IceyMu/Leverless-Controller/README.md

# Leverless-Controller
 A Leverless Controller for Fighting Games
