IceyMu/Leverless-Controller/Rev2/SLDPRT/Leverless Controller.SLDASM

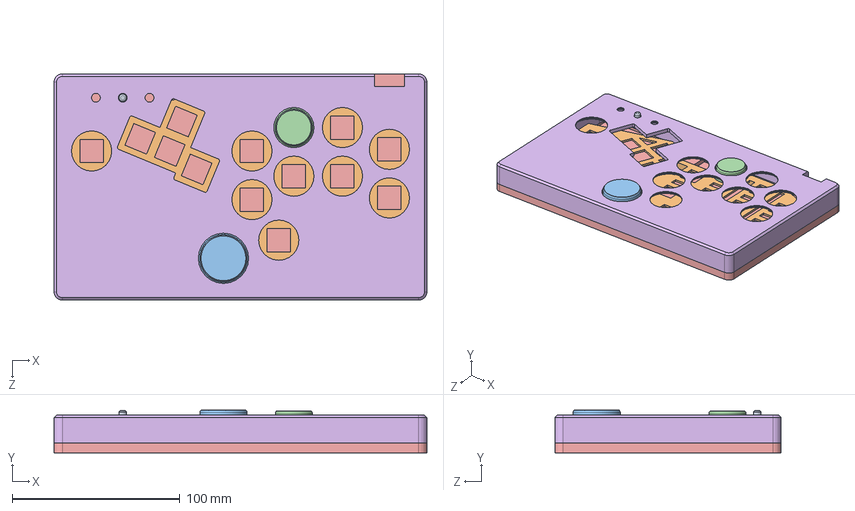
[picture p1: CAD file, 2025-10-01]
Rev2/SLDPRT/Leverless Controller.SLDASM
222.5 x 25.6 x 135.0 mm
top plate
bottom plate
24mm button
30mm button
key plate
5mm button
