IceyMu/Leverless-Controller/Rev2/KiCAD/daughter_board/daughter_board.step

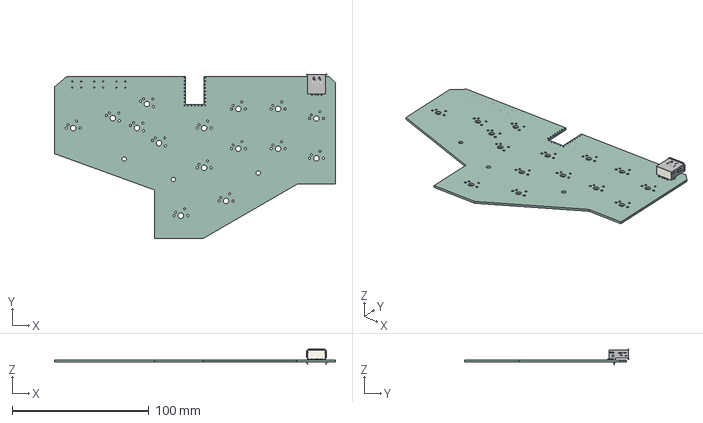
[picture p2: CAD file, 2025-10-01]
Rev2/KiCAD/daughter_board/daughter_board.step
205.2 x 119.9 x 11.4 mm
USB_A_TE_292303-7_Horizontal
daughter_board_PCB
