IceyMu/Leverless-Controller/Rev2/SLDPRT/24mm button.SLDPRT

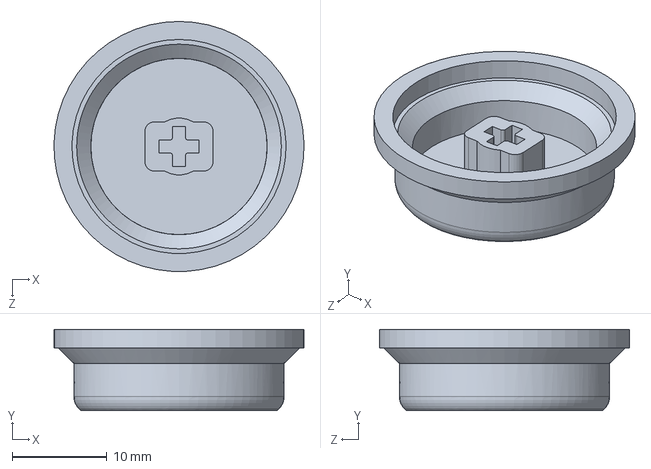
[picture p3: CAD file, 2025-10-01]
Rev2/SLDPRT/24mm button.SLDPRT
26.4 x 8.60 x 26.4 mm
