IceyMu/Leverless-Controller/Rev2/SLDPRT/bottom plate.SLDPRT

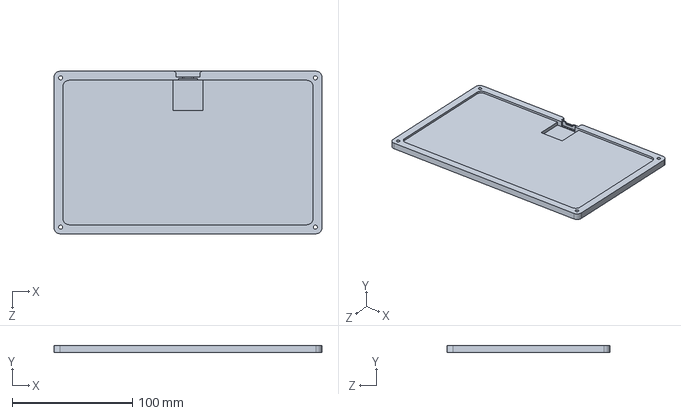
[picture p4: CAD file, 2025-10-01]
Rev2/SLDPRT/bottom plate.SLDPRT
222.5 x 6.00 x 135.0 mm
