IceyMu/Leverless-Controller/Rev2/SLDPRT/key plate.SLDPRT

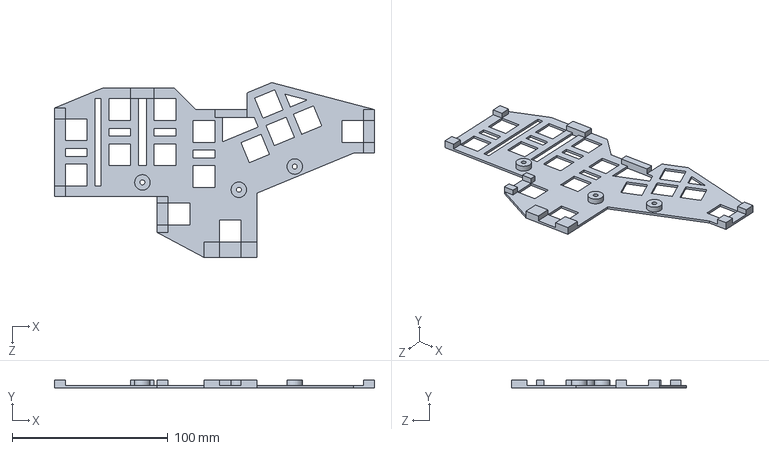
[picture p5: CAD file, 2025-10-01]
Rev2/SLDPRT/key plate.SLDPRT
205.7 x 5.00 x 112.4 mm
