IceyMu/Leverless-Controller/Rev2/SLDPRT/30mm button.SLDPRT

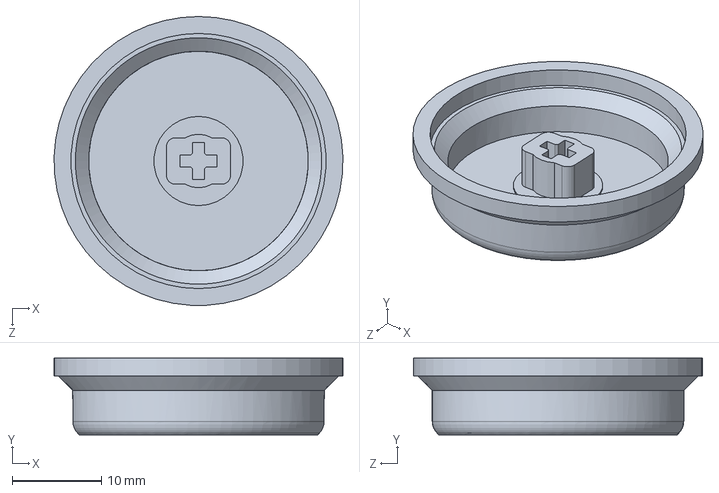
[picture p6: CAD file, 2025-10-01]
Rev2/SLDPRT/30mm button.SLDPRT
32.4 x 8.60 x 32.4 mm
