IceyMu/Leverless-Controller/Rev2/SLDPRT/5mm button.SLDPRT

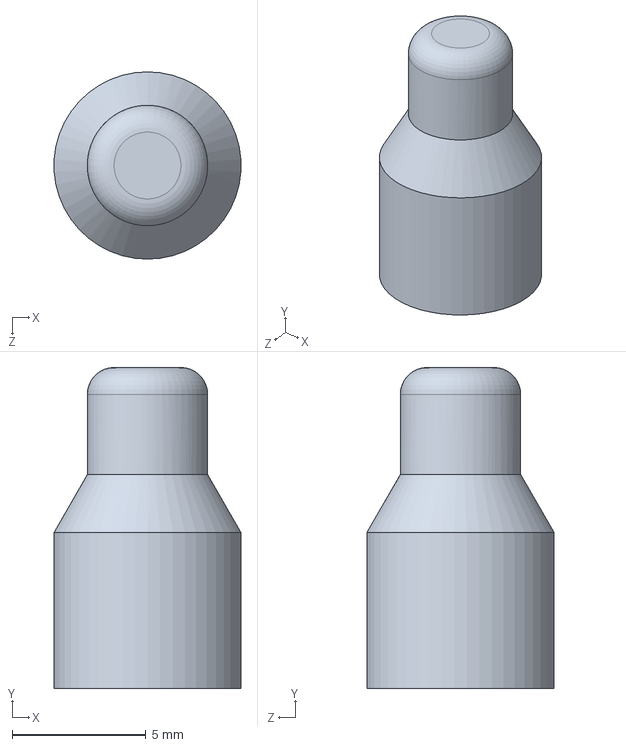
[picture p7: CAD file, 2025-10-01]
Rev2/SLDPRT/5mm button.SLDPRT
6.98 x 12.0 x 7.00 mm
