IceyMu/Leverless-Controller/Rev2/SLDPRT/top plate.SLDPRT

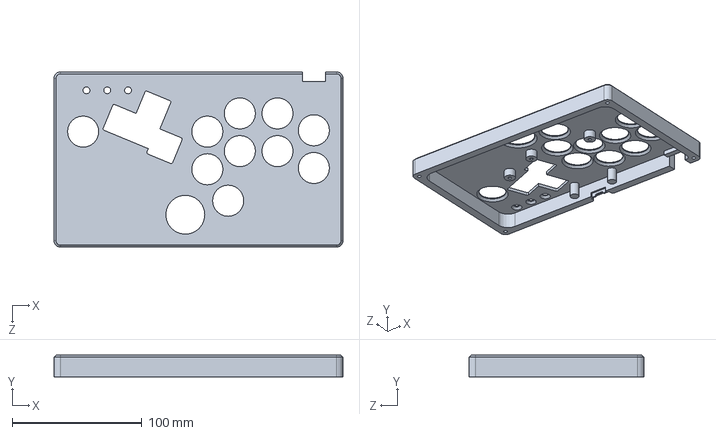
[picture p8: CAD file, 2025-10-01]
Rev2/SLDPRT/top plate.SLDPRT
222.5 x 16.6 x 135.0 mm
