IceyMu/Leverless-Controller/Rev1/STEP/leverless_controller_pcb.SLDASM

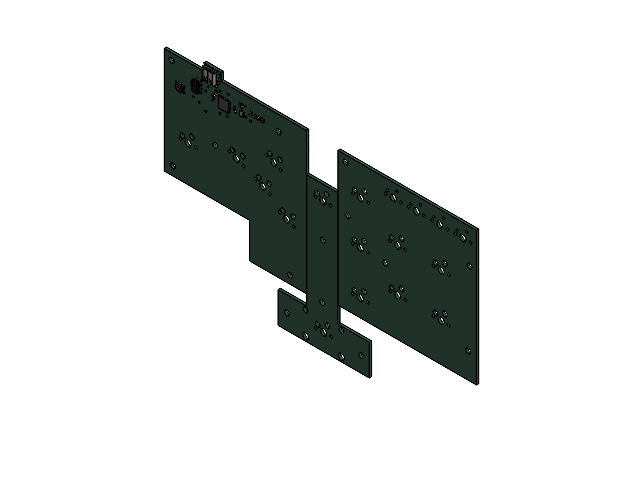
[picture p9: CAD file, 2024-09-28, an earlier design]
Rev1/STEP/leverless_controller_pcb.SLDASM
Crystal_SMD_3225-4Pin_3.2x2.5mm-0_1.step
LED_0805_2012Metric-1_1.step x 4
C_0402_1005Metric-2_1.step x 15
SW_SPST_TL3342-3_1.step
R_0402_1005Metric-4_1.step x 7
SOT_223_3.step
TestPoint_Bridge_Pitch2.54mm_Drill0.7mm-5_1.step
R_0603_1608Metric-6_1.step x 2
QFN_56_1EP_7x7mm_P04mm_EP32x32mm_3.step
USB_C_Receptacle_16P_TopMnt_Horizontal_GCT_USB4105-xx-A_3.step
leverless_controller_3board_PCB_1_1.step
leverless_controller_3board_PCB_2_1.step
leverless_controller_3board_PCB_3_1.step
