IceyMu/Leverless-Controller/(list of files, cad)

Other CAD files:
Rev1/STEP/LED_0805_2012Metric.step.SLDASM
Rev1/STEP/QFN-56-1EP_7x7mm_P0.4mm_EP3.2x3.2mm.step.SLDASM
Rev1/STEP/TestPoint_Bridge_Pitch2.54mm_Drill0.7mm.step.SLDASM
Rev1/STEP/SW_SPST_TL3342.step.SLDASM
Rev1/STEP/SOT-223.step.SLDASM
Rev1/STEP/R_0402_1005Metric.step.SLDASM
Rev1/STEP/USB_C_Receptacle_GCT_USB4105-xx-A_16P_TopMnt_Horizontal.step.SLDASM
Rev1/STEP/Crystal_SMD_3225-4Pin_3.2x2.5mm.step.SLDASM
Rev1/STEP/C_0402_1005Metric.step.SLDASM
Rev1/KiCAD/button_layout.DXF
Rev1/SLDPRT/24mm button.SLDPRT
Rev1/SLDPRT/24mm wide button.SLDPRT
Rev1/SLDPRT/30mm button.SLDPRT
Rev1/SLDPRT/5mm button.SLDPRT
Rev1/SLDPRT/baseplate.SLDPRT
Rev1/SLDPRT/keyswitch plate.SLDPRT
Rev1/SLDPRT/keyswitch standin.SLDPRT
Rev1/SLDPRT/light guide.SLDPRT
Rev1/SLDPRT/top plate.SLDPRT
Rev1/SLDPRT/xda_standin.SLDPRT
Rev1/STEP/TestPoint_Bridge_Pitch2.54mm_Drill0.7mm-5.step.SLDPRT
Rev1/STEP/[low detail] Low Profile Cherry MX Red.step
Rev1/STEP/leverless_controller.step
Rev1/STEP/leverless_controller_3board_PCB_2.step.SLDPRT
Rev1/STEP/leverless_controller_3board_PCB_3.step.SLDPRT
Rev1/STL/10mm button.STL
Rev1/STL/24mm button.STL
Rev1/STL/24mm wide button.STL
Rev1/STL/30mm button.STL
Rev1/STL/5mm button.STL
Rev1/STL/baseplate.STL
Rev1/STL/hole_tester.STL
Rev1/STL/key_stab_test.STL
Rev1/STL/key_stab_test.STL.SLDPRT
Rev1/STL/key_stem_test.STL
Rev1/STL/keyswitch plate.STL
Rev1/STL/keyswitch_plate.STL
Rev1/STL/light guide.STL
Rev1/STL/nut_tester.STL
Rev1/STL/plate stab spacing test.STL
Rev1/STL/scan_test.STL
Rev1/STL/scan_test_2.STL
Rev1/STL/stab_spacing_test.STL
Rev1/STL/top plate HOLLOW.STL
Rev1/STL/top plate SOLID.STL
Rev1/STL/top plate bottom ears.STL
Rev1/STL/top plate hollow ears.STL
Rev1/STL/top plate no scan test.STL
Rev1/STL/top plate no scan.STL
Rev1/STL/top plate scan.STL
Rev1/STL/top plate test.STL
Rev1/STL/top_plate.STL
Rev1/STL/wide_button_stab_test.STL
Rev2/SLDPRT/top plate.DXF
Rev2/STL/24mm button.STL
Rev2/STL/30mm button.STL
Rev2/STL/5mm button.STL
Rev2/STL/bottom plate.STL
Rev2/STL/key plate.STL
Rev2/STL/top plate.STL
