IceyMu/Leverless-Controller/Rev1/KiCAD/3_board - REV B/altered_schematic.pdf

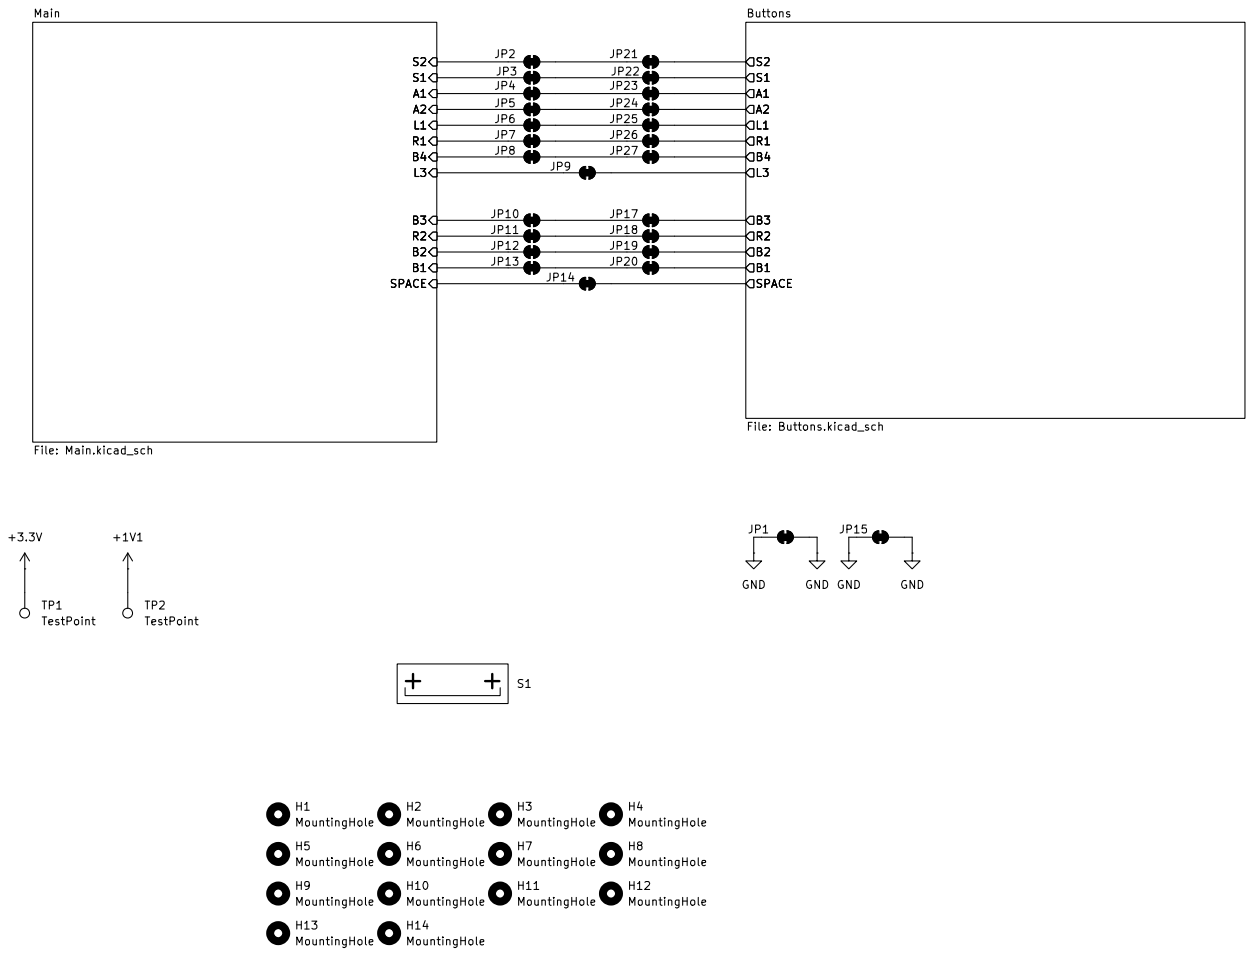
[picture p10: page 1]

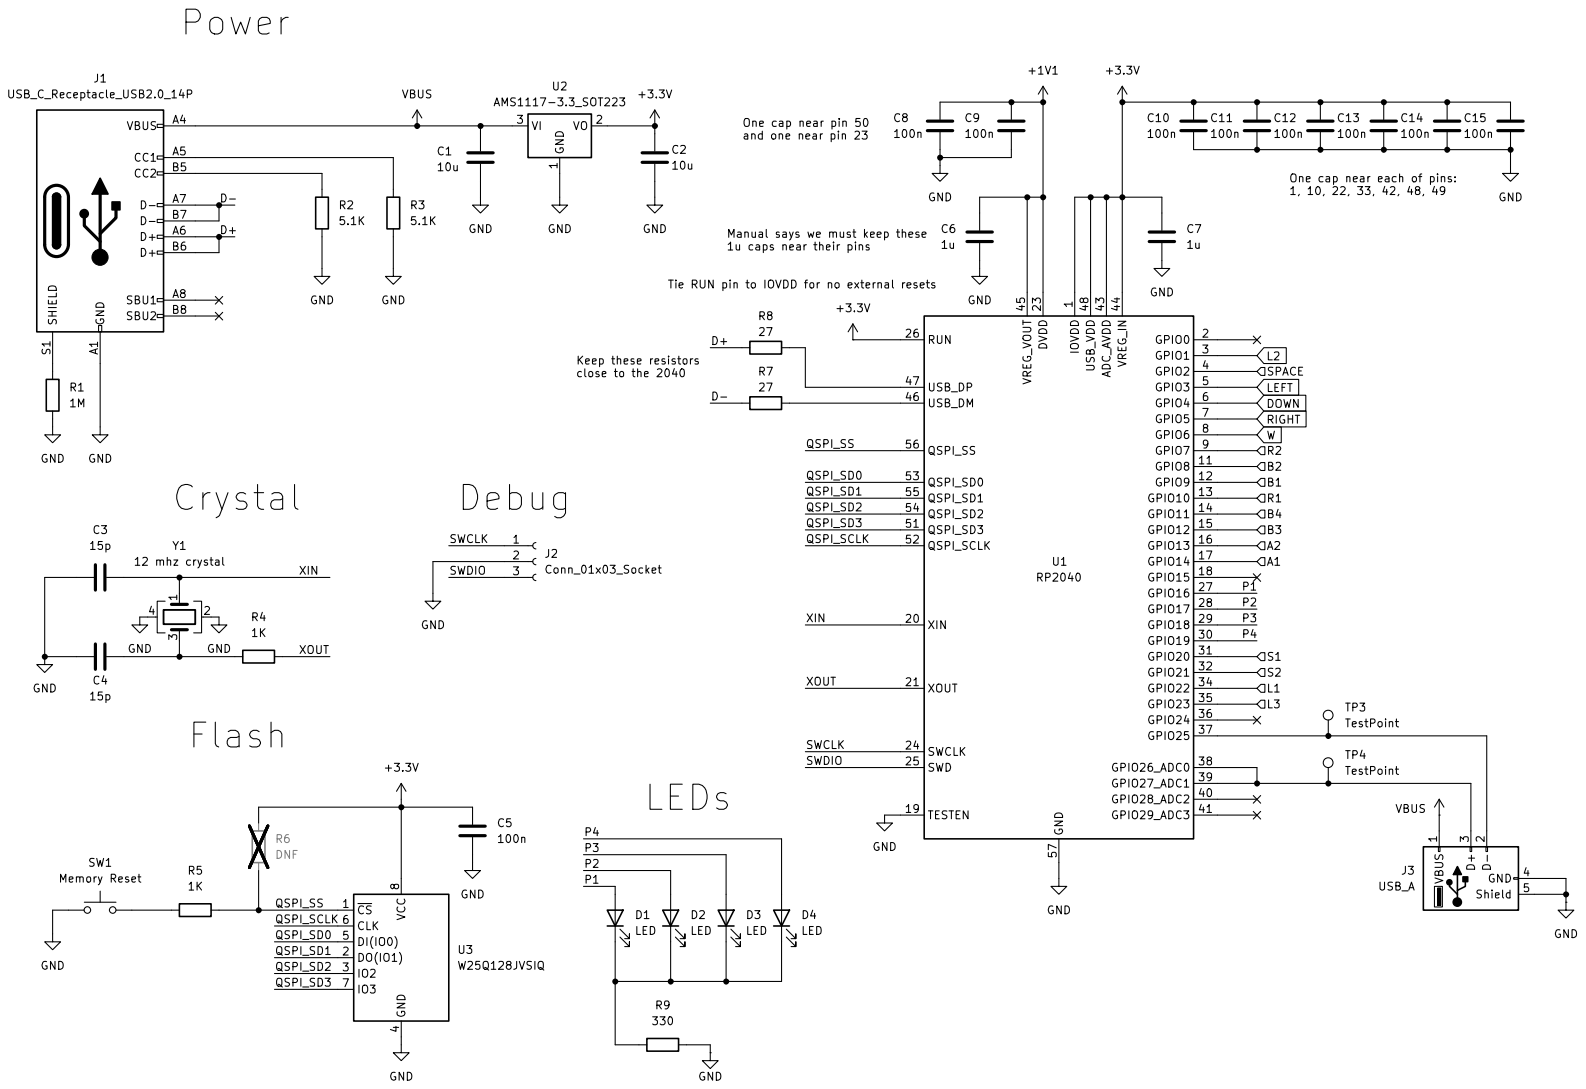
[picture p11: page 2]

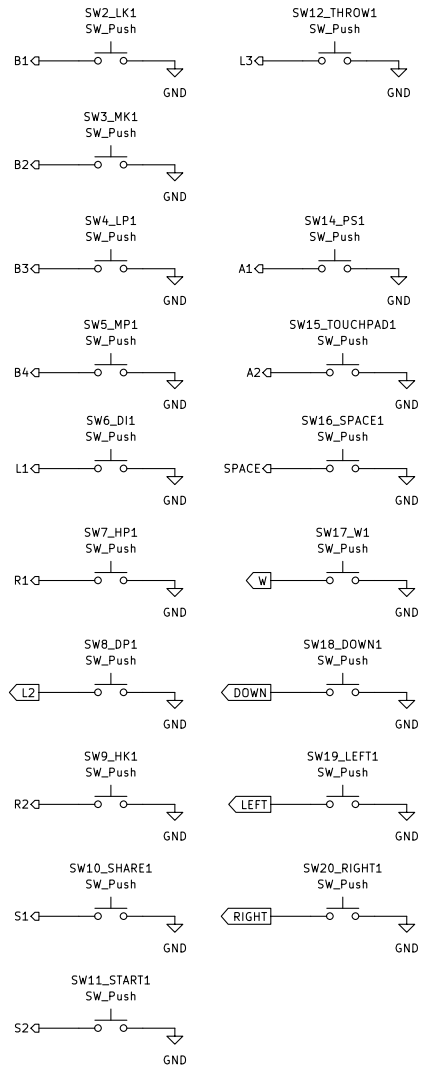
[picture p12: page 3]
