IceyMu/Leverless-Controller/Rev1/KiCAD/3_board - REV B/Schematic Rev A.pdf

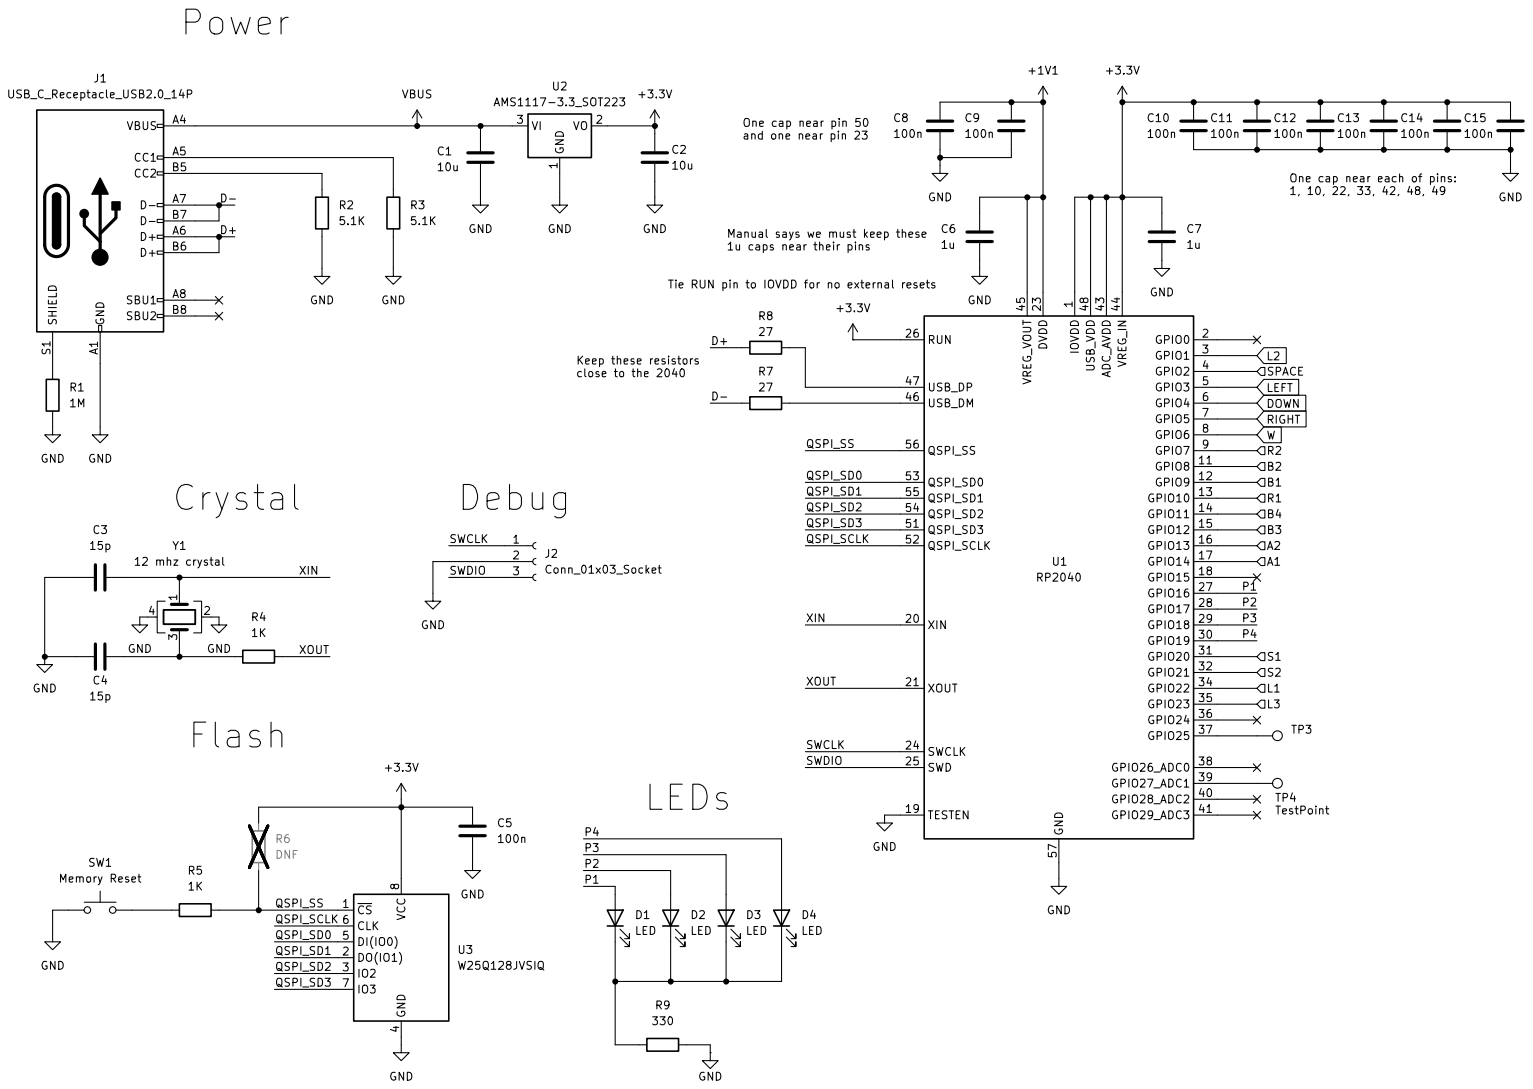
[picture p13: page 2]
