IceyMu/Leverless-Controller/Rev2/KiCAD/daughter_board/daughter_board.kicad_pcb

## KiCad design Rev2/KiCAD/daughter_board/daughter_board.kicad_pcb (2025-10-01)

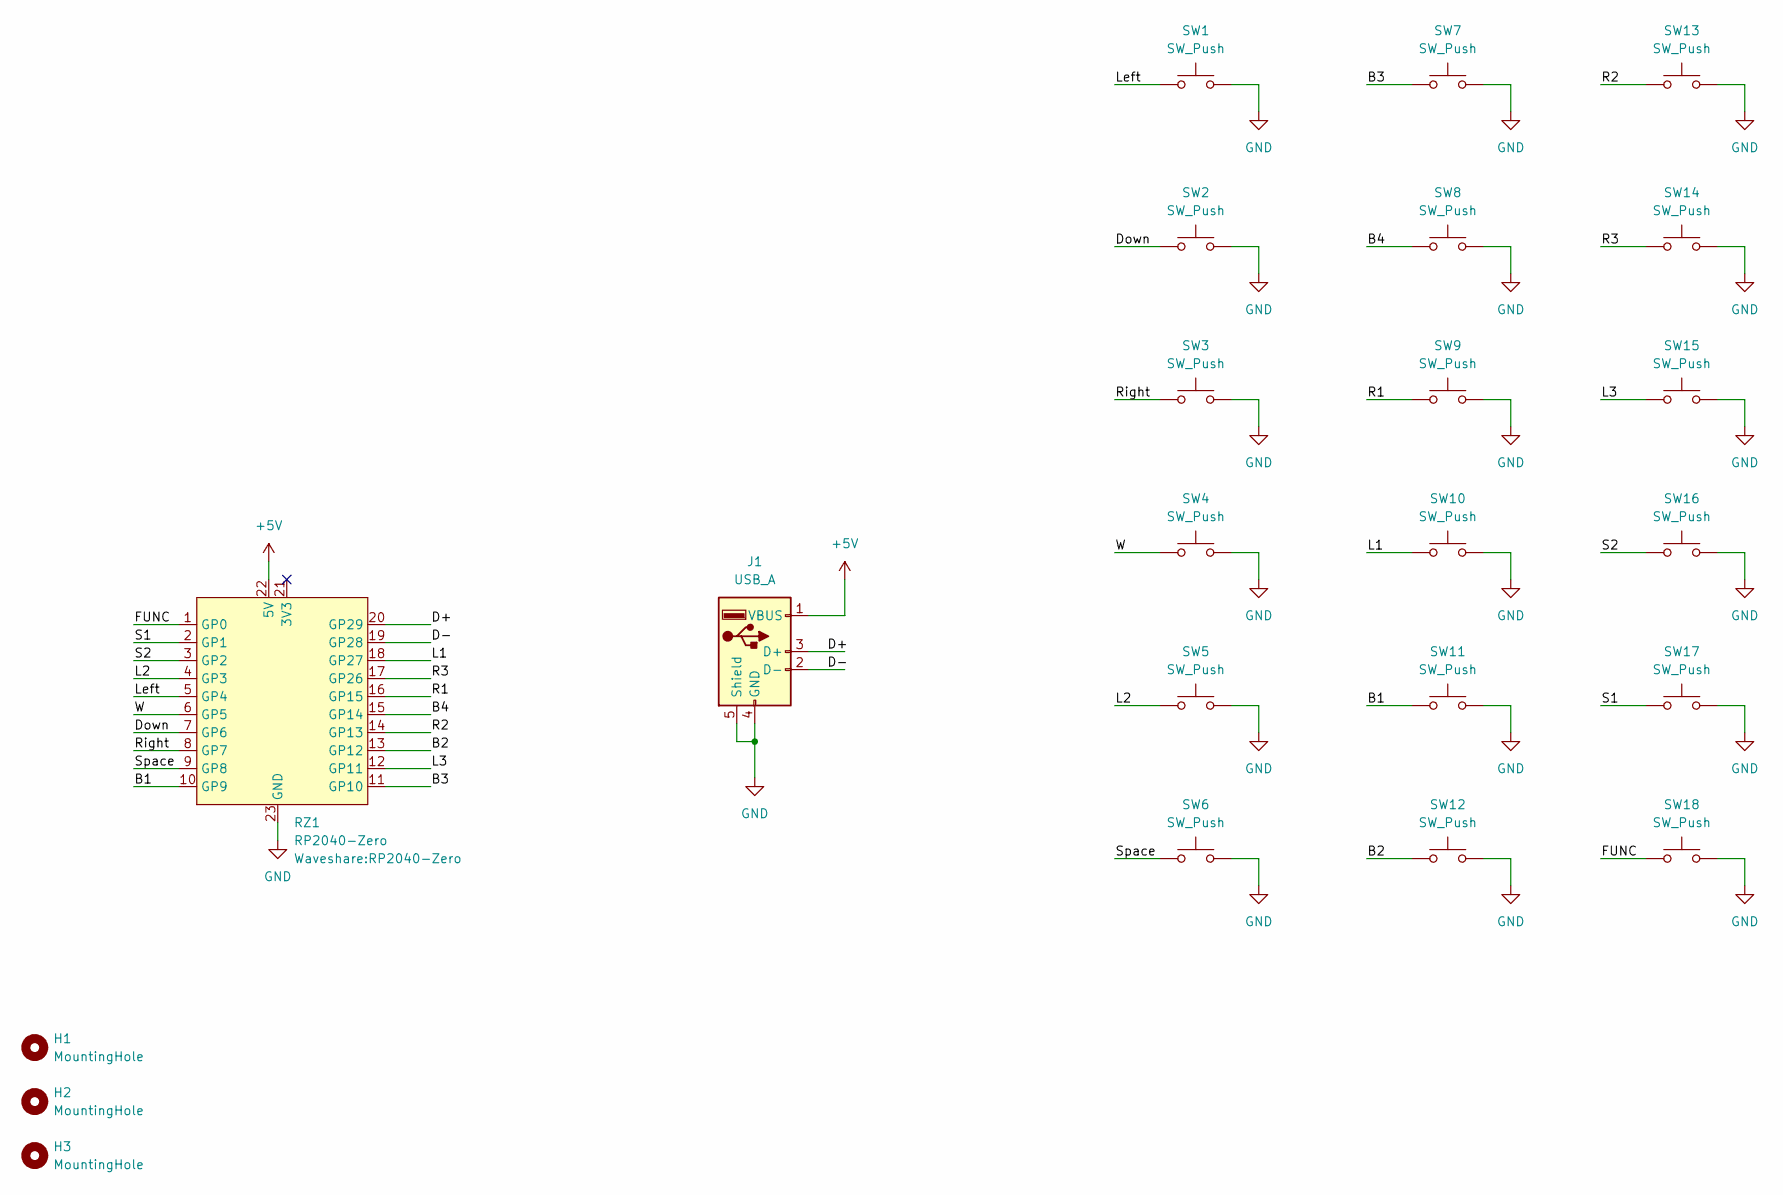
[picture p14: schematic daughter_board.kicad_sch]

Parts:
H1, H2, H3: MountingHole; MountingHole_3.2mm_M3
J1: USB_A; USB_A_TE_292303-7_Horizontal
RZ1: RP2040-Zero
SW1, SW2, SW3, SW4, SW5, SW6, SW7, SW8, SW9, SW10, SW11, SW12, SW13, SW14, SW15: SW_Push; SW_Gateron_LowProfile_THT
SW16, SW17, SW18: SW_Push; 6x6 vertical button

Connections:
+5V: J1.1 (VBUS), RZ1.22 (5V)
/B1: RZ1.10 (GP9), SW11.1
/B2: RZ1.13 (GP12), SW12.1
/B3: RZ1.11 (GP10), SW7.1
/B4: RZ1.15 (GP14), SW8.1
/D+: J1.3 (D+), RZ1.20 (GP29)
/D-: J1.2 (D-), RZ1.19 (GP28)
/Down: RZ1.7 (GP6), SW2.1
/FUNC: RZ1.1 (GP0), SW18.1
/L1: RZ1.18 (GP27), SW10.1
/L2: RZ1.4 (GP3), SW5.1
/L3: RZ1.12 (GP11), SW15.1
/Left: RZ1.5 (GP4), SW1.1
/R1: RZ1.16 (GP15), SW9.1
/R2: RZ1.14 (GP13), SW13.1
/R3: RZ1.17 (GP26), SW14.1
/Right: RZ1.8 (GP7), SW3.1
/S1: RZ1.2 (GP1), SW17.1
/S2: RZ1.3 (GP2), SW16.1
/Space: RZ1.9 (GP8), SW6.1
/W: RZ1.6 (GP5), SW4.1
GND: J1.4 (GND), J1.5 (Shield), RZ1.23 (GND), SW1.2, SW2.2, SW3.2, SW4.2, SW5.2, SW6.2, SW7.2, SW8.2, SW9.2, SW10.2, SW11.2, SW12.2, SW13.2, SW14.2, SW15.2, SW16.2, SW17.2, SW18.2

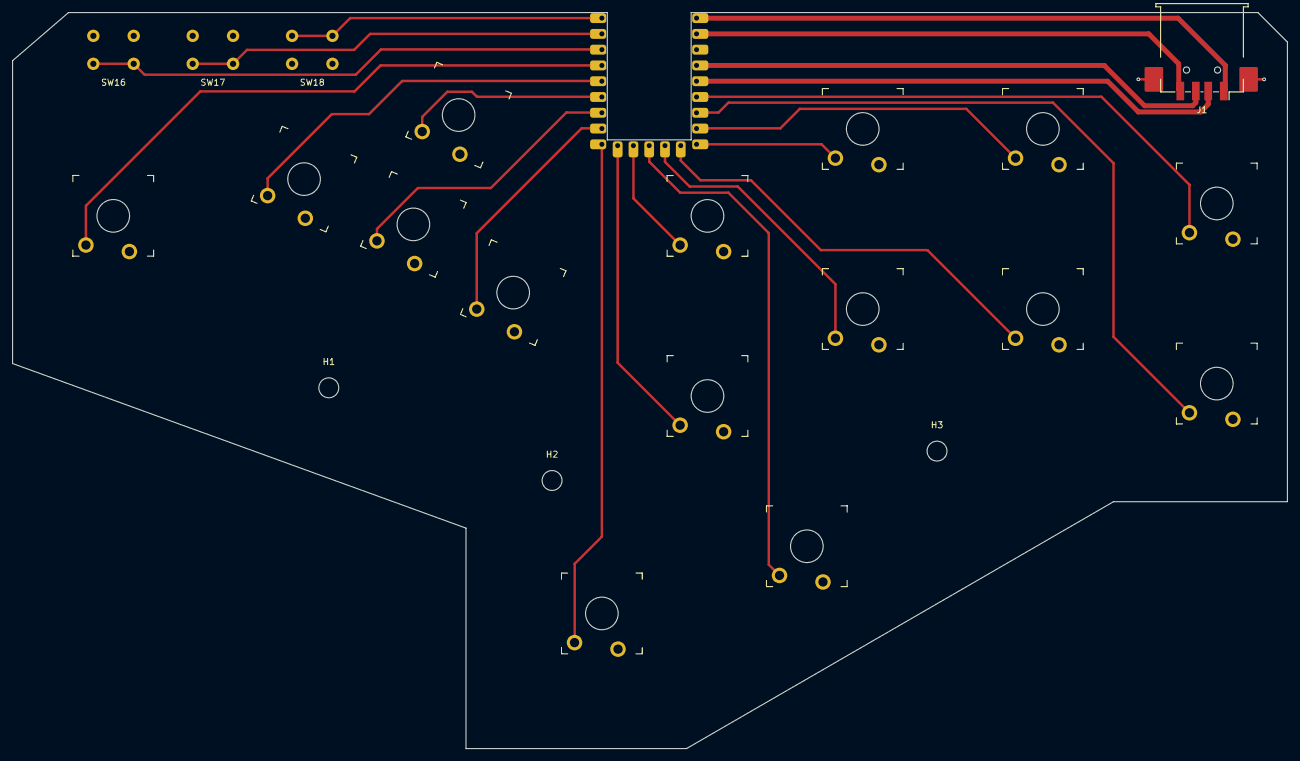
[picture p15: board daughter_board.kicad_pcb from above]

Board: 2 copper layers, 205.2 x 118.5 mm, 23 parts (1 on the bottom side), 22 nets.
