IceyMu/Leverless-Controller/KiCAD/4_board/leverless_controlller_4board.kicad_pcb

## KiCad design KiCAD/4_board/leverless_controlller_4board.kicad_pcb (2024-07-24)

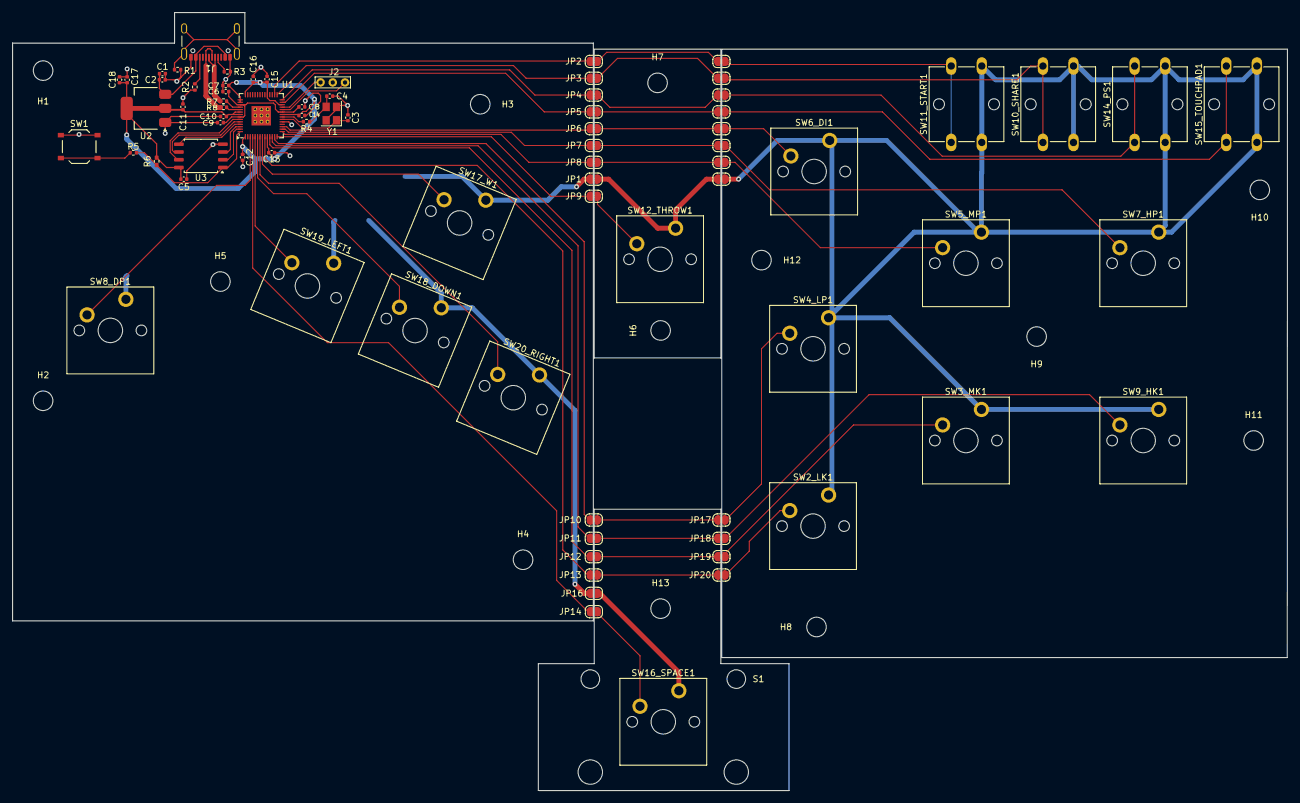
[picture p16: board leverless_controlller_4board.kicad_pcb from above]

Board: 2 copper layers, 208.5 x 127.2 mm, 96 parts (0 on the bottom side), 65 nets.

Parts:
B1, B2, B3, B4: Board
C1, C2, C17, C18: 4.7u; C_0402_1005Metric
C3, C4: 15p; C_0402_1005Metric
C5, C8, C9, C10, C11, C12, C13, C14, C15, C16: 100n; C_0402_1005Metric
C6, C7: 1u; C_0402_1005Metric
H1, H2, H3, H4, H5, H6, H7, H8, H9, H10, H11, H12, H13: MountingHole; MountingHole_3.2mm_M3
J1: USB_C_Receptacle_USB2.0_14P; USB_C_Receptacle_U262-161N-4BVC11
J2: Conn_01x03_Socket; Debug_Points
JP1, JP2, JP3, JP4, JP5, JP6, JP7, JP8, JP9, JP10, JP11, JP12, JP13, JP14, JP15, JP16, JP17, JP18, JP19, JP20, JP21, JP22, JP23, JP24, JP25, JP26, JP27: SolderJumper_2_Bridged; EdgeSolderJumper-2_P1.3mm_Bridged_RoundedPad1.0x1.5mm
R1: 1M; R_0402_1005Metric
R2, R3: 5.1K; R_0402_1005Metric
R4, R5: 1K; R_0402_1005Metric
R6: DNF; R_0402_1005Metric_Pad0.72x0.64mm_HandSolder
R7, R8: 27; R_0402_1005Metric
S1: Stabilizer_Cherry_MX_2.00u
SW1: Memory Reset; SW_TS-1187A-C-A-B
SW2_LK1, SW3_MK1, SW4_LP1, SW5_MP1, SW6_DI1, SW7_HP1, SW8_DP1, SW9_HK1, SW12_THROW1, SW16_SPACE1: SW_Push; SW_Cherry_MX_PCB
SW10_SHARE1, SW11_START1, SW14_PS1, SW15_TOUCHPAD1: SW_Push; SW_SPST_Omron_B3F-40xx
SW17_W1, SW18_DOWN1, SW19_LEFT1, SW20_RIGHT1: SW_Push; SW_Cherry_MX_PCB_1.00u
U1: RP2040; QFN-56-1EP_7x7mm_P0.4mm_EP3.2x3.2mm
U2: AMS1117-3.3_SOT223; SOT-223-3_TabPin2
U3: W25Q128JVSIQ; SOIC-8_5.23x5.23mm_P1.27mm
Y1: 12 mhz crystal; Crystal_SMD_3225-4Pin_3.2x2.5mm

Connections:
+1V1: C6.1, C8.1, C9.1, U1.23 (DVDD), U1.45 (VREG_VOUT), U1.50 (DVDD)
+3.3V: C5.1, C7.1, C10.1, C11.1, C12.1, C13.1, C14.1, C15.1, C16.1, C17.1, C18.1, R6.1, U1.1 (IOVDD), U1.10 (IOVDD), U1.22 (IOVDD), U1.26 (RUN), U1.33 (IOVDD), U1.42 (IOVDD), U1.43 (ADC_AVDD), U1.44 (VREG_IN), U1.48 (USB_VDD), U1.49 (IOVDD), U2.2 (VO), U3.8 (VCC)
/Buttons/A1: JP23.2 (B), SW14_PS1.1
/Buttons/A2: JP24.2 (B), SW15_TOUCHPAD1.1
/Buttons/B1: JP20.2 (B), SW2_LK1.1
/Buttons/B2: JP19.2 (B), SW3_MK1.1
/Buttons/B3: JP17.2 (B), SW4_LP1.1
/Buttons/B4: JP27.2 (B), SW5_MP1.1
/Buttons/L1: JP25.2 (B), SW6_DI1.1
/Buttons/L3: JP9.2 (B), SW12_THROW1.1
/Buttons/R1: JP26.2 (B), SW7_HP1.1
/Buttons/R2: JP18.2 (B), SW9_HK1.1
/Buttons/S1: JP22.2 (B), SW10_SHARE1.1
/Buttons/S2: JP21.2 (B), SW11_START1.1
/Buttons/SPACE: JP14.2 (B), SW16_SPACE1.1
/Main/A1: JP4.1 (A), U1.28 (GPIO17)
/Main/A2: JP5.1 (A), U1.27 (GPIO16)
/Main/B1: JP13.1 (A), U1.9 (GPIO7)
/Main/B2: JP12.1 (A), U1.11 (GPIO8)
/Main/B3: JP10.1 (A), U1.13 (GPIO10)
/Main/B4: JP8.1 (A), U1.15 (GPIO12)
/Main/D+: J1.A6 (D+), J1.B6 (D+), R8.1
/Main/D-: J1.A7 (D-), J1.B7 (D-), R7.1
/Main/L1: JP6.1 (A), U1.17 (GPIO14)
/Main/L3: JP9.1 (A), U1.14 (GPIO11)
/Main/QSPI_SCLK: U1.52 (QSPI_SCLK), U3.6 (CLK)
/Main/QSPI_SD0: U1.53 (QSPI_SD0), U3.5 (DI(IO0))
/Main/QSPI_SD1: U1.55 (QSPI_SD1), U3.2 (DO(IO1))
/Main/QSPI_SD2: U1.54 (QSPI_SD2), U3.3 (IO2)
/Main/QSPI_SD3: U1.51 (QSPI_SD3), U3.7 (IO3)
/Main/QSPI_SS: R5.2, R6.2, U1.56 (QSPI_SS), U3.1 (~CS)
/Main/R1: JP7.1 (A), U1.16 (GPIO13)
/Main/R2: JP11.1 (A), U1.12 (GPIO9)
/Main/S1: JP3.1 (A), U1.29 (GPIO18)
/Main/S2: JP2.1 (A), U1.30 (GPIO19)
/Main/SPACE: JP14.1 (A), U1.4 (GPIO2)
/Main/SWCLK: J2.1, U1.24 (SWCLK)
/Main/SWDIO: J2.3, U1.25 (SWD)
/Main/XIN: C3.2, U1.20 (XIN), Y1.1
/Main/XOUT: R4.2, U1.21 (XOUT)
DOWN: SW18_DOWN1.1, U1.6 (GPIO4)
GND: C1.2, C2.2, C3.1, C4.1, C5.2, C6.2, C7.2, C8.2, C9.2, C10.2, C11.2, C12.2, C13.2, C14.2, C15.2, C16.2, C17.2, C18.2, J1.A1 (GND), J1.A12 (GND), J1.B1 (GND), J1.B12 (GND), J2.2, JP1.1 (A), JP1.2 (B), JP15.1 (A), JP15.2 (B), JP16.1 (A), JP16.2 (B), R1.2, R2.2, R3.2, SW1.1, SW2_LK1.2, SW3_MK1.2, SW4_LP1.2, SW5_MP1.2, SW6_DI1.2, SW7_HP1.2, SW8_DP1.2, SW9_HK1.2, SW10_SHARE1.2, SW11_START1.2, SW12_THROW1.2, SW14_PS1.2, SW15_TOUCHPAD1.2, SW16_SPACE1.2, SW17_W1.2, SW18_DOWN1.2, SW19_LEFT1.2, SW20_RIGHT1.2, U1.19 (TESTEN), U1.57 (GND), U2.1 (GND), U3.4 (GND), Y1.2, Y1.4
L2: SW8_DP1.1, U1.3 (GPIO1)
LEFT: SW19_LEFT1.1, U1.5 (GPIO3)
unnamed: C4.2, R4.1, Y1.3
unnamed: J1.A5 (CC1), R3.1
unnamed: J1.B5 (CC2), R2.1
unnamed: J1.S1 (SHIELD), R1.1
unnamed: JP2.2 (B), JP21.1 (A)
unnamed: JP10.2 (B), JP17.1 (A)
unnamed: JP11.2 (B), JP18.1 (A)
unnamed: JP12.2 (B), JP19.1 (A)
unnamed: JP13.2 (B), JP20.1 (A)
unnamed: JP3.2 (B), JP22.1 (A)
unnamed: JP4.2 (B), JP23.1 (A)
unnamed: JP5.2 (B), JP24.1 (A)
unnamed: JP6.2 (B), JP25.1 (A)
unnamed: JP7.2 (B), JP26.1 (A)
unnamed: JP8.2 (B), JP27.1 (A)
unnamed: R5.1, SW1.2
unnamed: R7.2, U1.46 (USB_DM)
unnamed: R8.2, U1.47 (USB_DP)
RIGHT: SW20_RIGHT1.1, U1.7 (GPIO5)
VBUS: C1.1, C2.1, J1.A4 (VBUS), J1.A9 (VBUS), J1.B4 (VBUS), J1.B9 (VBUS), U2.3 (VI)
W: SW17_W1.1, U1.8 (GPIO6)
