IceyMu/Leverless-Controller/Rev1/KiCAD/3_board - REV B/3board_b.kicad_pcb

## KiCad design Rev1/KiCAD/3_board - REV B/3board_b.kicad_pcb (2024-07-29, an earlier design)

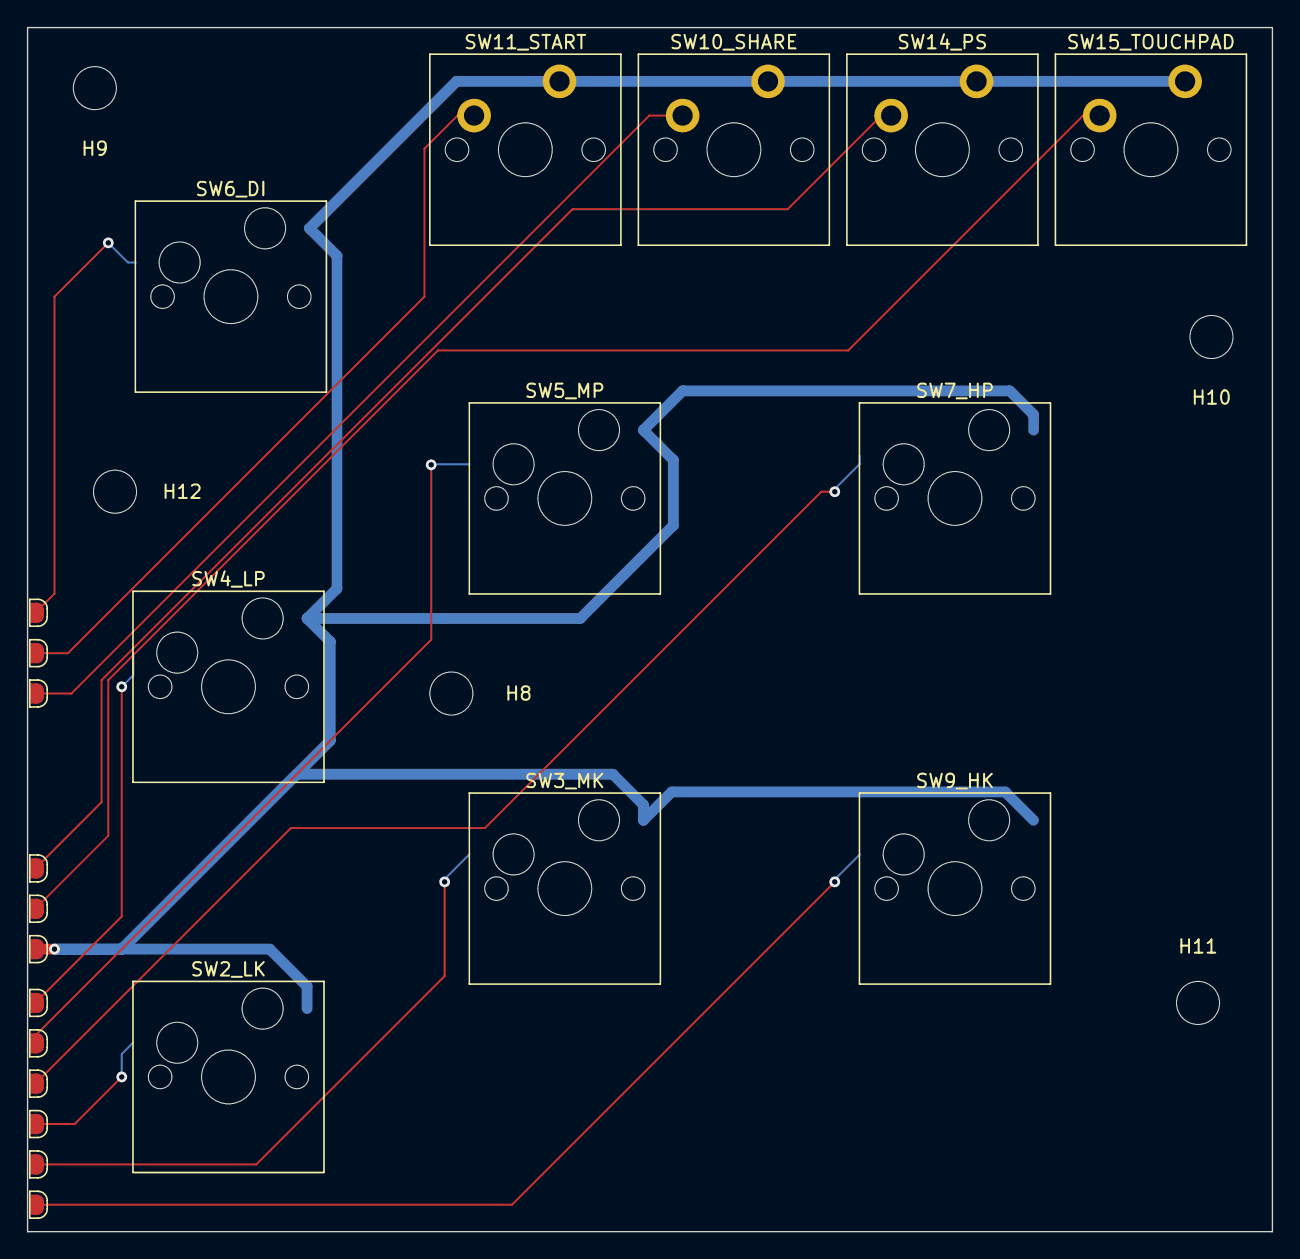
[picture p17: board 3board_b.kicad_pcb from above]

Board: 2 copper layers, 92.5 x 89.5 mm, 29 parts (0 on the bottom side), 12 nets.

Parts:
B2: Board
H8, H9, H10, H11, H12: MountingHole; MountingHole_3.2mm_M3
JP15, JP17, JP18, JP19, JP20, JP21, JP22, JP23, JP24, JP25, JP26, JP27: SolderJumper_2_Bridged; EdgeSolderJumper-2_Right_Half
SW2_LK, SW3_MK, SW4_LP, SW5_MP, SW6_DI, SW7_HP, SW9_HK: SW_Push; SW_Hotswap_Kailh_MX
SW10_SHARE, SW11_START, SW14_PS, SW15_TOUCHPAD: SW_Push; SW_Cherry_MX_PCB

Connections:
/Buttons/A1: JP23.2 (B), SW14_PS.1
/Buttons/A2: JP24.2 (B), SW15_TOUCHPAD.1
/Buttons/B1: JP20.2 (B), SW2_LK.1
/Buttons/B2: JP19.2 (B), SW3_MK.1
/Buttons/B3: JP17.2 (B), SW4_LP.1
/Buttons/B4: JP27.2 (B), SW5_MP.1
/Buttons/L1: JP25.2 (B), SW6_DI.1
/Buttons/R1: JP26.2 (B), SW7_HP.1
/Buttons/R2: JP18.2 (B), SW9_HK.1
/Buttons/S1: JP22.2 (B), SW10_SHARE.1
/Buttons/S2: JP21.2 (B), SW11_START.1
GND: JP15.2 (B), SW2_LK.2, SW3_MK.2, SW4_LP.2, SW5_MP.2, SW6_DI.2, SW7_HP.2, SW9_HK.2, SW10_SHARE.2, SW11_START.2, SW14_PS.2, SW15_TOUCHPAD.2
