IceyMu/Leverless-Controller/(commit log)

2024-07-18 Start PCB Layout
    [Buttons.kicad_sch, Main.kicad_sch, leverless_controlller.kicad_pcb, leverless_controlller.kicad_sch]
2024-07-18 PCB First Draft
    [Buttons.kicad_sch, Main.kicad_sch, leverless_controlller.kicad_pcb, leverless_controlller.kicad_sch]
2024-07-19 Make PCB and case fit together
    [24mm button.SLDPRT, 24mm wide button.SLDPRT, 30mm button.SLDPRT, Buttons.kicad_sch, Main.kicad_sch, bottom_half.SLDPRT, button_layout.DXF, leverless_controlller.SLDASM]
2024-07-19 First DFM pass
    [Main.kicad_sch, leverless_controlller.kicad_pcb]
2024-07-21 Second DFM pass
    [Main.kicad_sch, leverless_controlller.kicad_pcb]
2024-07-22 Add foot prints
2024-07-23 Add multiboard configurations
    [Buttons.kicad_sch, Main.kicad_sch, leverless_controlller.kicad_sch, leverless_controlller_multiboard.kicad_pcb, leverless_controlller_multiboard.kicad_sch]
2024-07-24 Panelize 4 board design
    [2board_a-B_Cu.gbr, 2board_a-B_Mask.gbr, 2board_a-B_Paste.gbr, 2board_a-B_Silkscreen.gbr, 2board_a-Edge_Cuts.gbr, 2board_a-F_Cu.gbr, 2board_a-F_Mask.gbr, 2board_a-F_Paste.gbr]
2024-07-25 4 board DFM pass
    [4board_a.kicad_pcb, 4board_b.kicad_pcb, Buttons.kicad_sch, Main.kicad_sch, bom_jlc.csv, bom_nextpcb.csv, leverless_controller_4board.kicad_pcb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]
2024-07-25 Update Case for 4 board
    [4board_a.step, 4board_b.step, 4board_c.step, 4board_d.step, bottom_half.SLDPRT, leverless_controlller.SLDASM, leverless_controlller.step, top_plate.SLDPRT]
2024-07-26 Add silkscreen images
    [bom_jlc.csv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]
2024-07-29 PCB Order Version
    [4board_a.kicad_pcb, 4board_b.kicad_pcb, 4board_c.kicad_pcb, 4board_d.kicad_pcb, Buttons.kicad_sch, Main.kicad_sch, bom_jlc.csv, leverless_controller_4board.kicad_pcb]
2024-07-29 Add 3 Board (New Order Version)
    [3board_a.kicad_pcb, 3board_b.kicad_pcb, 3board_c.kicad_pcb, Buttons.kicad_sch, Main.kicad_sch, leverless_controller_3board.kicad_pcb, leverless_controller_3board.kicad_sch]
2024-07-29 Fix missing connection to HP
    [3board_b.kicad_pcb, leverless_controller_3board.kicad_pcb]
2024-07-30 Update CAD model based on PCB order
    [24mm button.SLDPRT, 24mm wide button.SLDPRT, 30mm button.SLDPRT, 4board_a.step, 4board_b.step, 4board_c.step, 4board_d.step, bottom_half.SLDPRT]
2024-07-30 Remove Outdated PCB Configurations
    [2board_a-B_Cu.gbr, 2board_a-B_Mask.gbr, 2board_a-B_Paste.gbr, 2board_a-B_Silkscreen.gbr, 2board_a-Edge_Cuts.gbr, 2board_a-F_Cu.gbr, 2board_a-F_Mask.gbr, 2board_a-F_Paste.gbr]
2024-07-31 Correct 27ohm resistor footprint to 0603 and add 10mm button
    [10mm button.SLDPRT, 10mm button.STL, 24mm button.SLDPRT, 24mm button.STL, 24mm wide button.STL, 30mm button.STL, 3board_a.kicad_pcb, Main.kicad_sch]
2024-08-16 Add Keyswitch Plate and Light Guide
    [10mm button.SLDPRT, 24mm button.SLDPRT, 24mm wide button.SLDPRT, 30mm button.SLDPRT, 5mm button.SLDPRT, C_0402_1005Metric.step.SLDASM, Crystal_SMD_3225-4Pin_3.2x2.5mm.step.SLDASM, LED_0805_2012Metric.step.SLDASM]
2024-08-16 Update STLs
    [24mm button.STL, 24mm wide button.STL, 30mm button.STL, 5mm button.STL, bottom_half.SLDPRT, bottom_half.STL, keyswitch_plate.STL, leverless_controller.SLDASM]
2024-08-21 Add revision marker to PCB
2024-08-26 Correct Board 3 Revision Marker
2024-09-16 Redo solidworks files, make rev a files match order version, make rev b
    [24mm button.SLDPRT, 24mm button.STL, 24mm wide button.SLDPRT, 24mm wide button.STL, 30mm button.SLDPRT, 30mm button.STL, 3board_a.kicad_pcb, 3board_b.kicad_pcb]
2024-09-28 Assembled Version
    [10mm button.SLDPRT, 24mm button.SLDPRT, 24mm wide button.SLDPRT, 24mm wide button.STL, 30mm button.SLDPRT, 30mm button.STL, 5mm button.SLDPRT, 5mm button.STL]
2024-11-24 Improve Key Stab Connection
    [24mm button.STL, 24mm wide button.SLDPRT, 24mm wide button.STL]
2025-10-01 Add second revision
    [10mm button.STL, 24mm button.SLDPRT, 24mm button.STL, 24mm wide button.SLDPRT, 24mm wide button.STL, 30mm button.SLDPRT, 30mm button.STL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]
